JonathanCamenzuli/UG_FYP/src/coap_server/utils/README.md

In this folder, a `.env` is used and not available in the public repo. The following environment variables are used in said `.env` file:

```.env
INFLUXDB_URL    # URL of InfluxDB Instance
INFLUXDB_TOKEN  # Token provided by InfluxDB
INFLUXDB_ORG    # InfluxDB Organisation
INFLUXDB_BUCKET # InfluxDB Bucket
```
