JonathanCamenzuli/UG_FYP/docs/jc_fyp_presentation.pdf

# Miniature Implementation

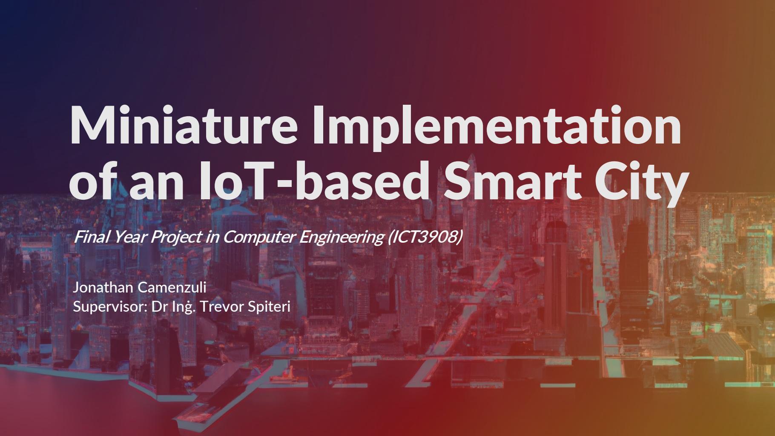
[picture p18: page 1]

Final Year Project in Computer Engineering (ICT3908)

Jonathan Camenzuli
Supervisor: Dr Inġ. Trevor Spiteri

# of an IoT‐based Smart City

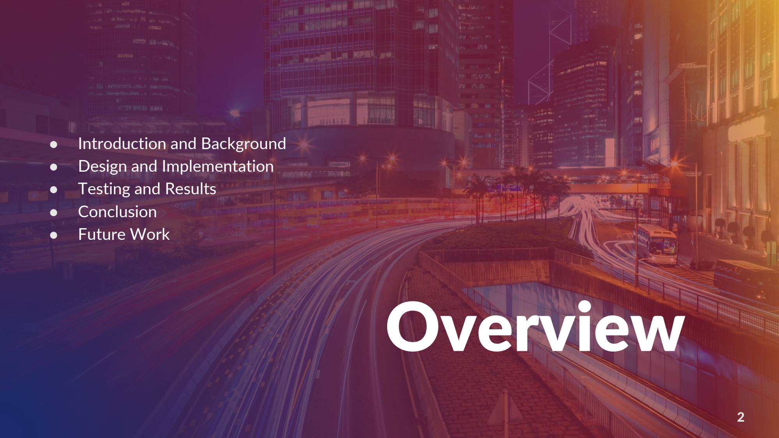
[picture p19: page 2]

# Overview

- Introduction and Background
- Design and Implementation
- Testing and Results
- Conclusion
- Future Work

2

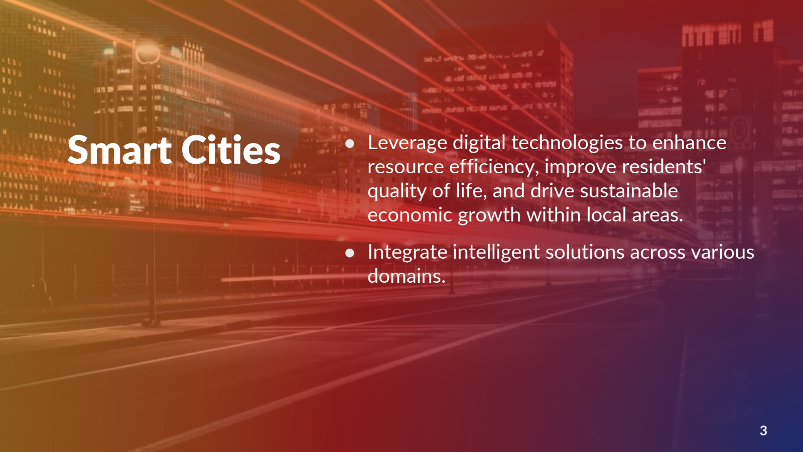
[picture p20: page 3]

Smart Cities | ● Leverage digital technologies to enhance resource efficiency, improve residents' quality of life, and drive sustainable economic growth within local areas.
| ● Integrate intelligent solutions across various domains.

3

# Technologies Enabling Smart Cities

## AI/ML

Pattern Recognition and
Autonomous System Management

## Distributed Ledger Technologies

Secure Transactions and Identities

## Internet of Things

Real-world Interface.

4

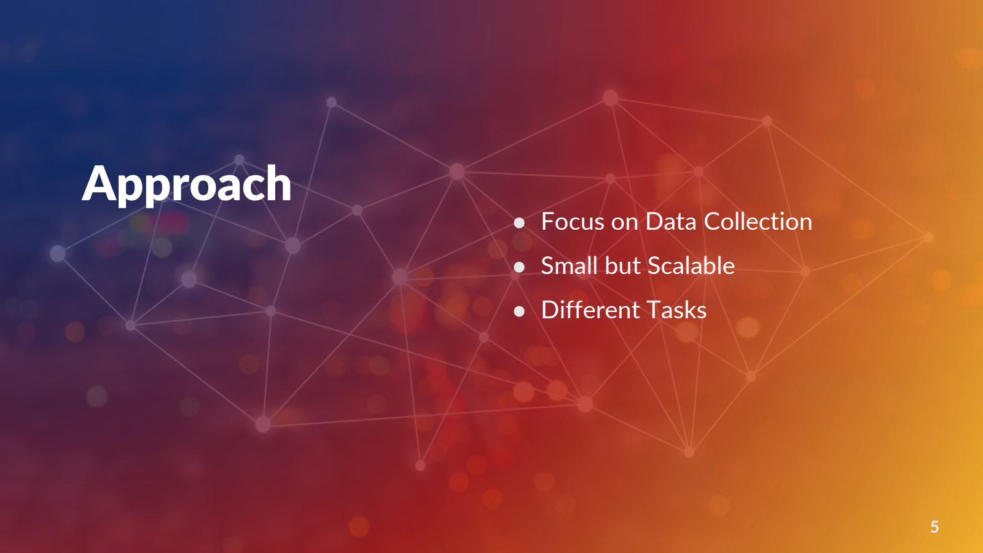
[picture p21: page 5]

# Approach

- Focus on Data Collection
- Small but Scalable
- Different Tasks

5

- Arduino MKR NB 1500
- SAMD21 Cortex®-M0+ 32bit low power ARM MCU
- u‐blox SARA‐R4 module for Narrowband Connectivity

# Physical Nodes

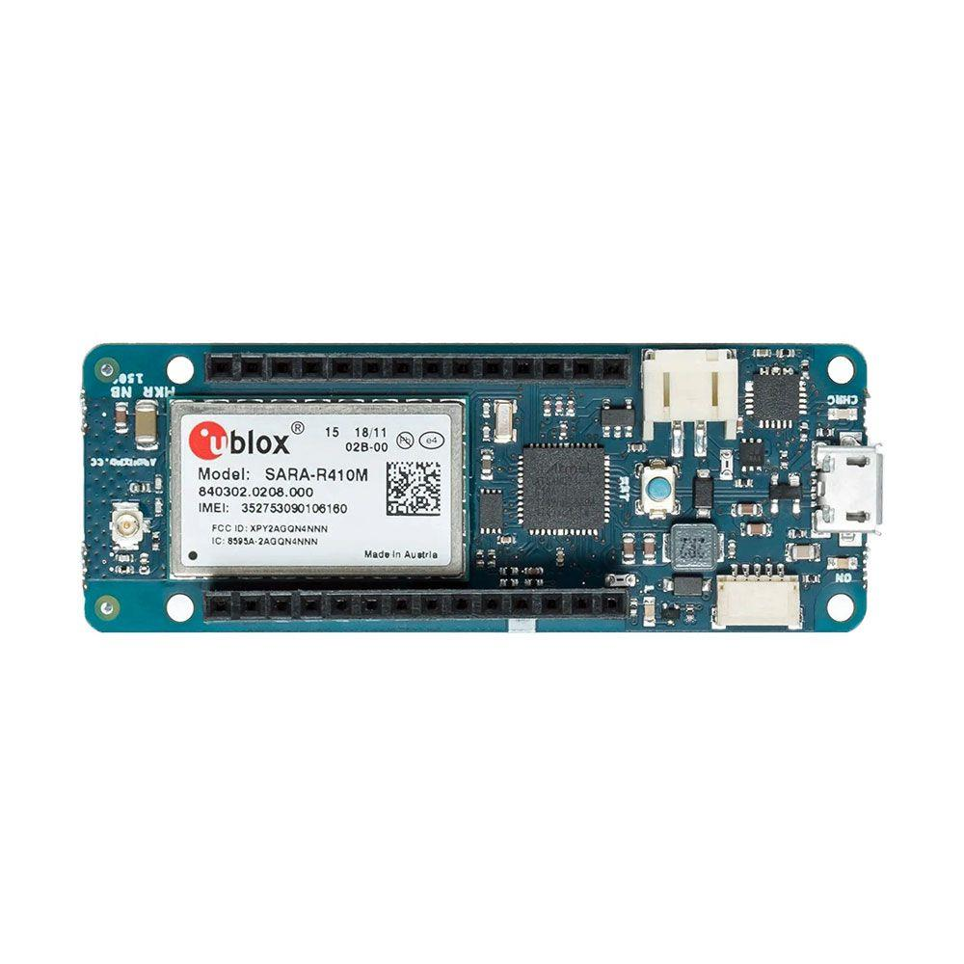
[picture p22: figure]

6

# Car Park Sensor

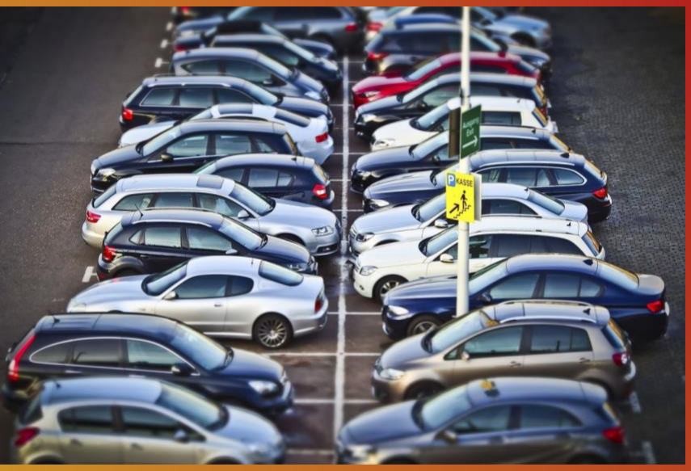
[picture p23: figure]

- Proof of concept based on a single parking spot
- Event-based
- Detects whether there is a vehicle present on the sensor
- Makes use of the HC-SR04 Ultrasonic Sensor

7

# Air Quality Monitoring System

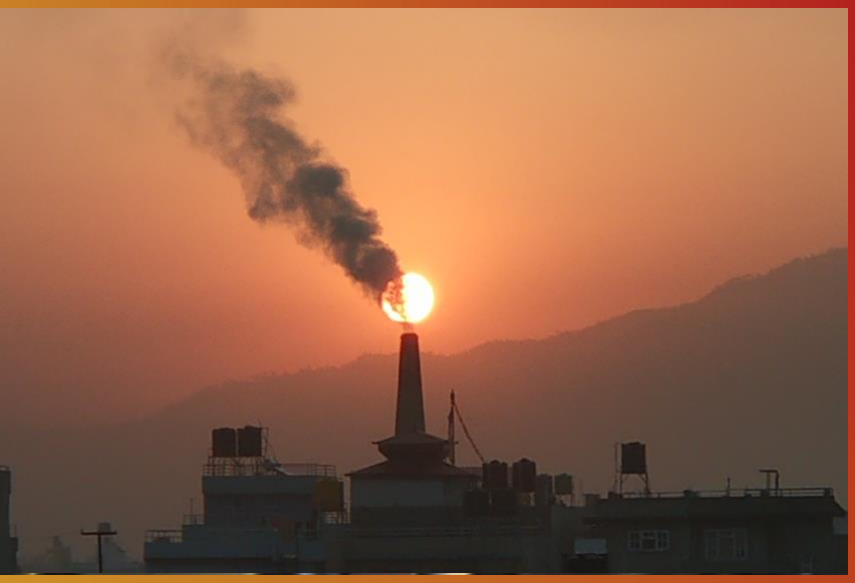
[picture p24: figure]

- Measures temperature, humidity and CO, CO2 PPM levels
- Makes use of DHT11 for measuring temperature, humidity
- Makes use of MQ-135 for
measuring CO, CO2 PPM levels

8

# Fire Detection System

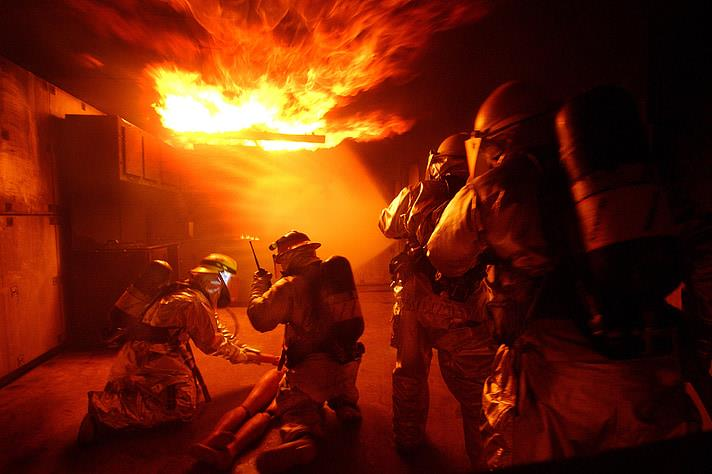
[picture p25: figure]

- Measures temperature, humidity and CO, smoke PPM levels,
presence of infrared
- Makes use of DHT11 for measuring temperature, humidity
- Makes use of MQ-4 for measuring CO, smoke PPM levels
- Makes use of an IR module for detecting infrared

9

- Centralised Server
- Star Topology
- Data Sent to the Server by making use of CoAP and NB-IoT

# System Architecture

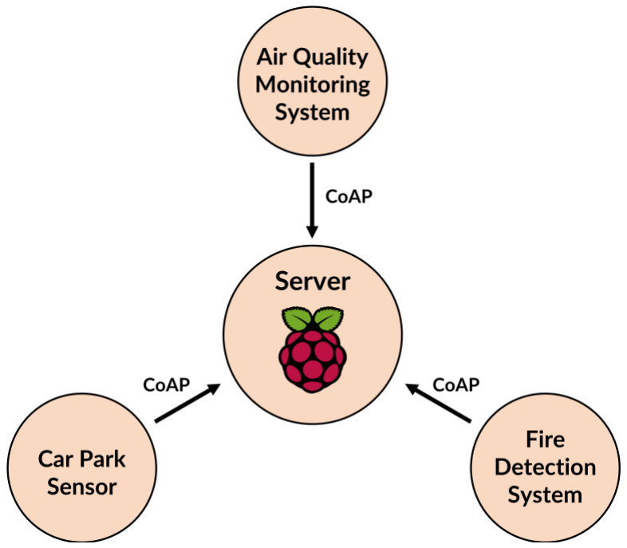
[picture p26: figure]

10

# Data Collection Pipeline

11

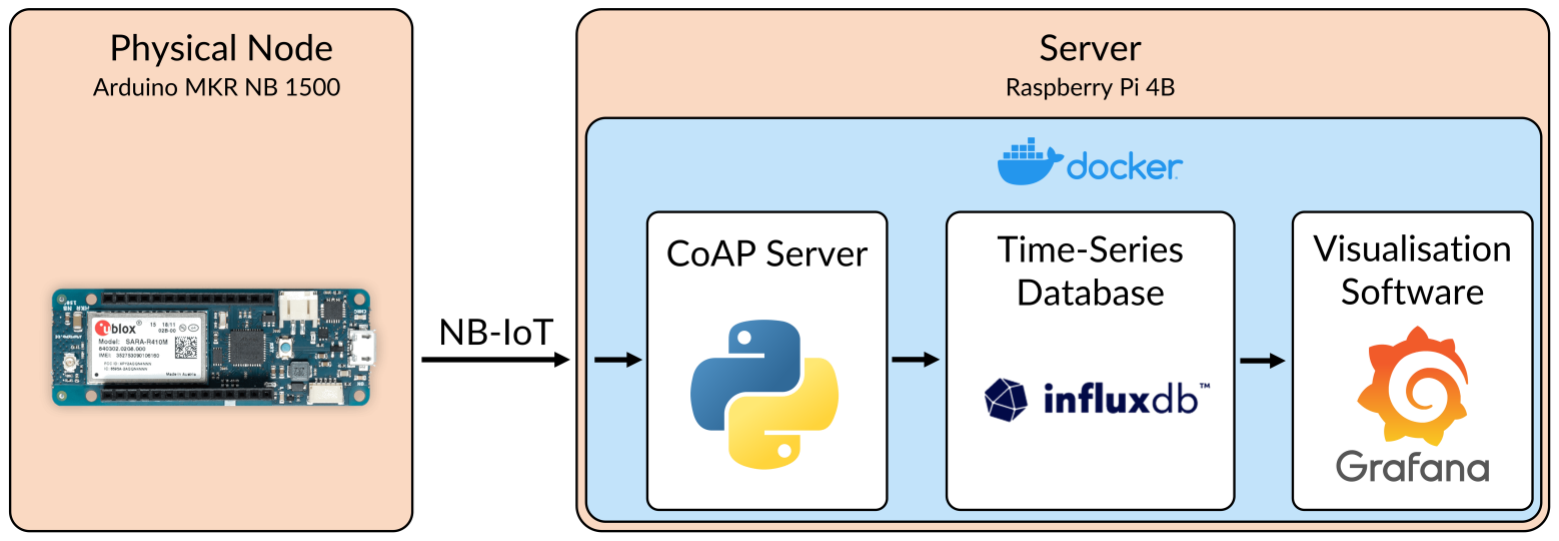
[picture p27: figure]
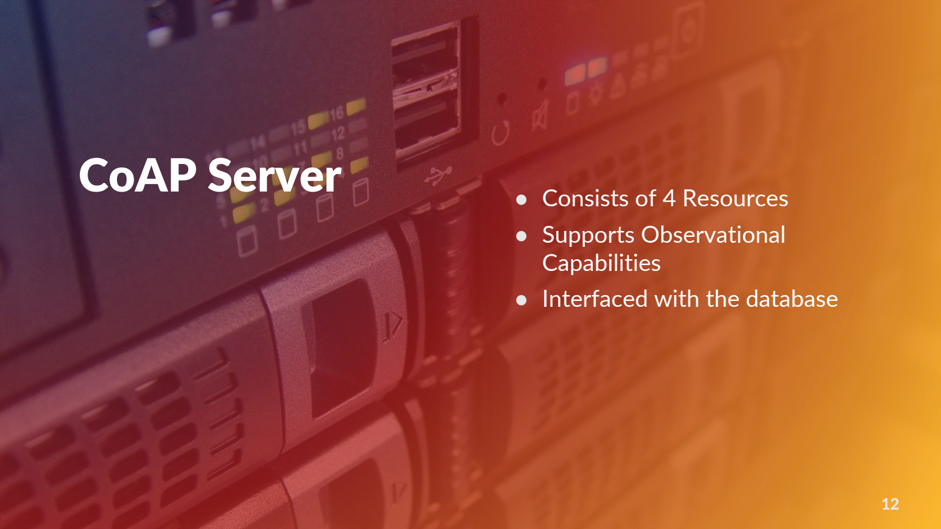
[picture p28: page 12]

# CoAP Server

- Consists of 4 Resources
- Supports Observational
Capabilities
- Interfaced with the database

12

# CoAP Server

13

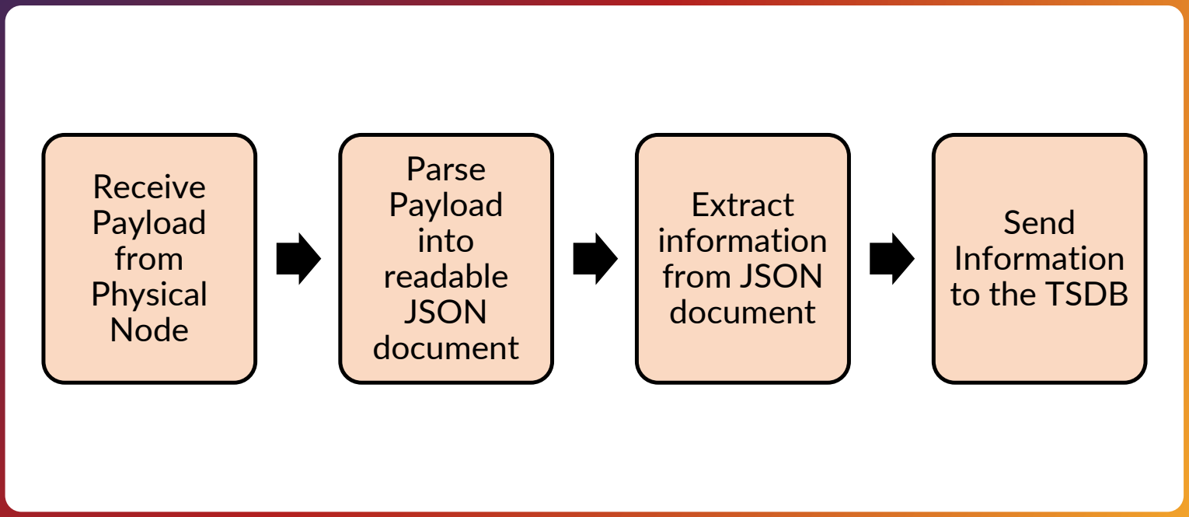
[picture p29: figure]
Receive Payload from Physical Node; Parse Payload into readable JSON document; Extract information from JSON document; Send Information to the TSDB

# Time Series

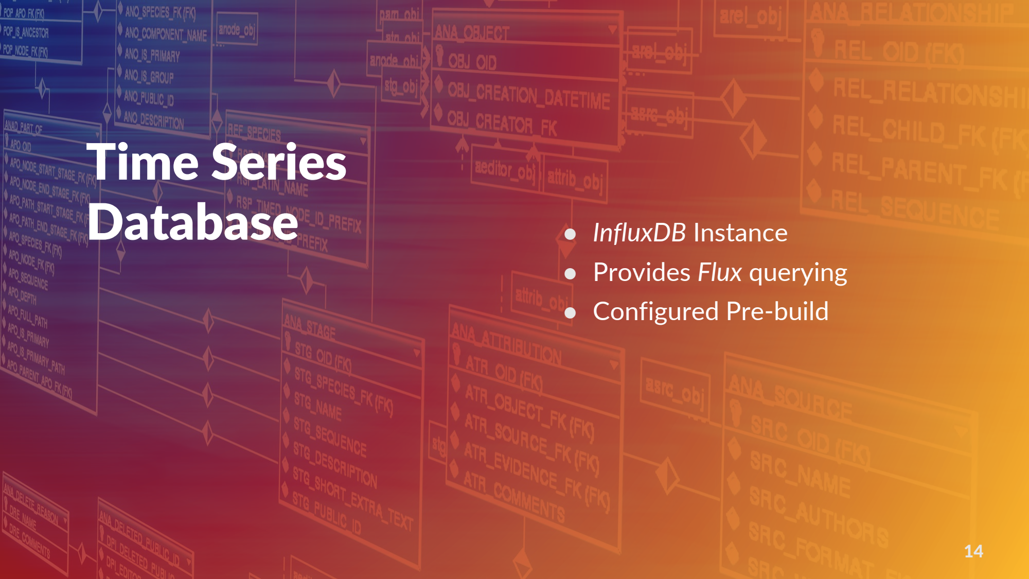
[picture p30: page 14]

Database | ● InfluxDB Instance
| ● Provides Flux querying ● Configured Pre-build

14

# Visualisation

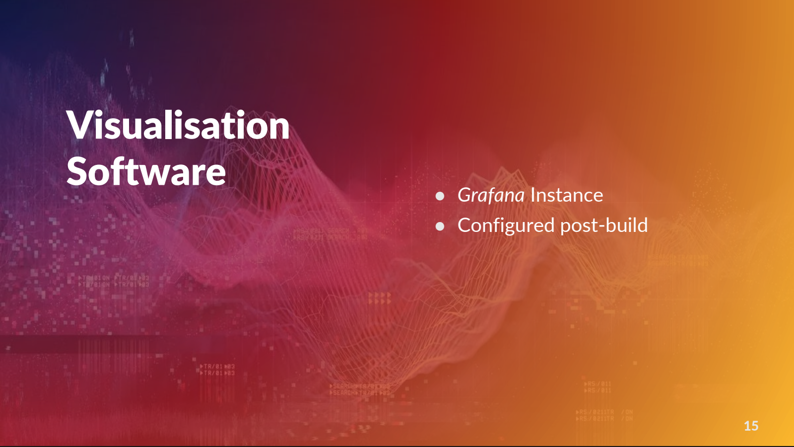
[picture p31: page 15]

# Software

- Grafana Instance
- Configured post-build

15

# Visualisation Software

16

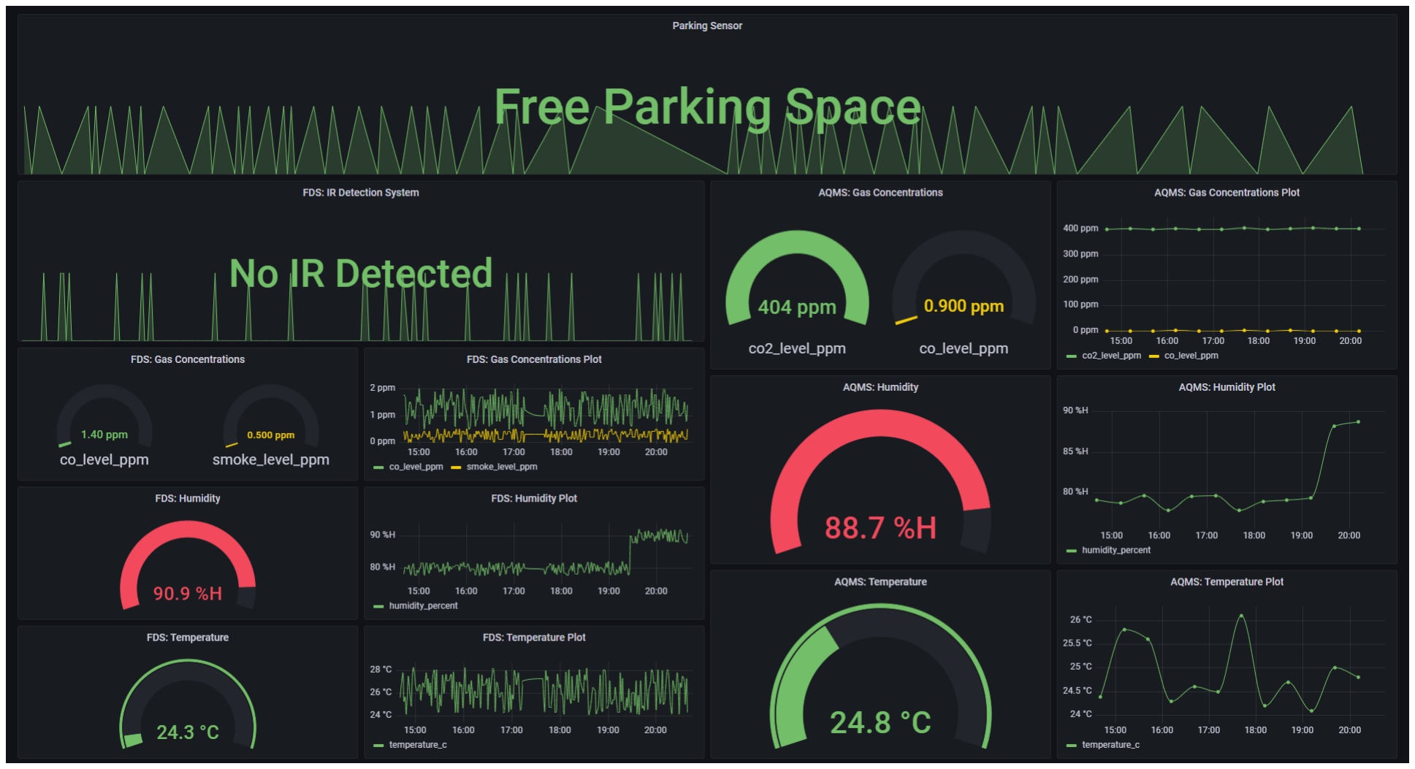
[picture p32: figure]

# Visualisation Software

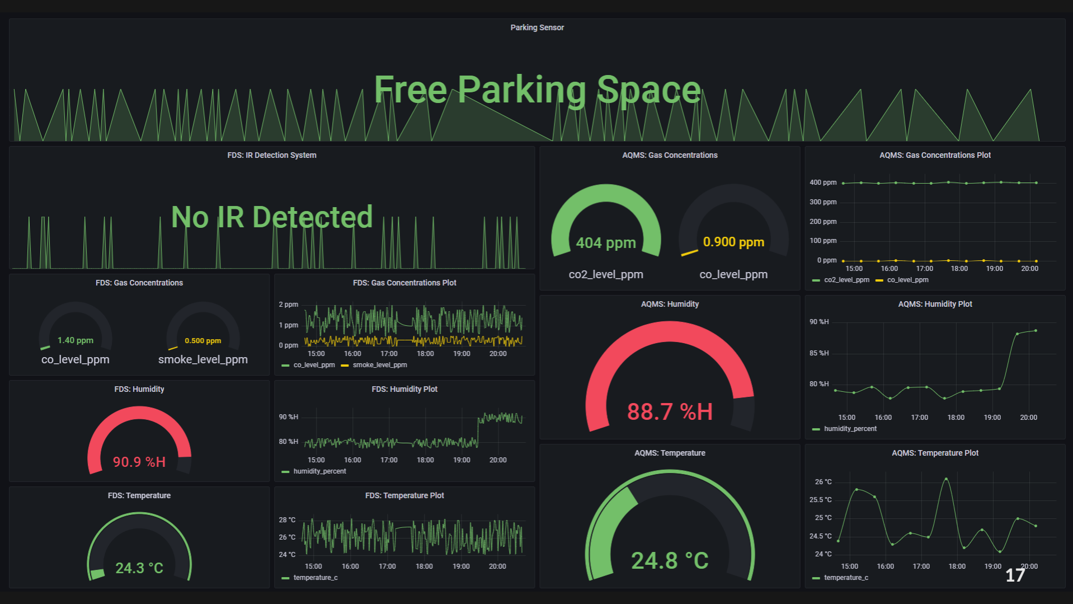
[picture p33: page 17]

17

# Prototyping

18

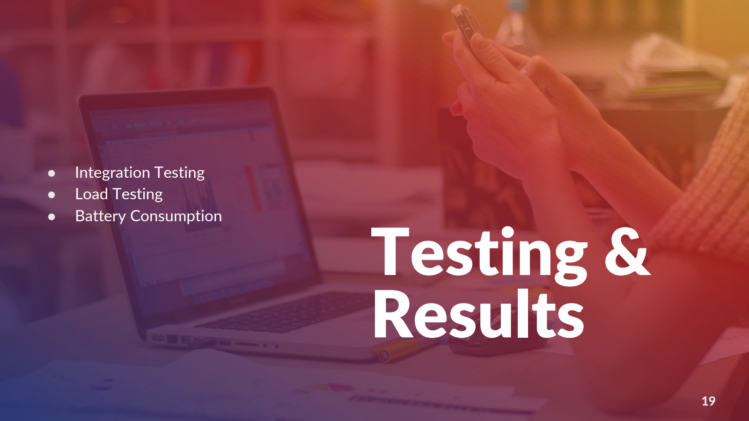
[picture p34: page 19]

# Testing & Results

- | Integration Testing ● | Load Testing ● | Battery Consumption

19

# Integration Testing

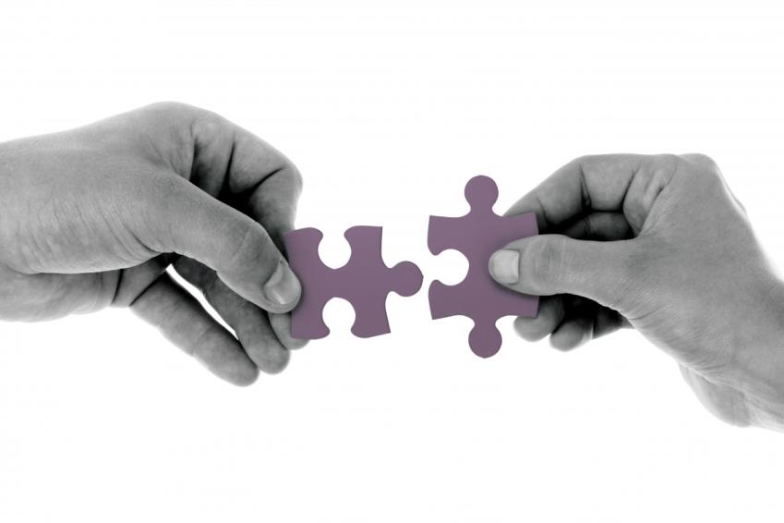
[picture p35: figure]

- Ensures proper integration and communication of all components.
- Involved sending data from test physical node to the server and verifying its receipt and processing.
- Data transmission and receipt were confirmed

20

# Load Testing

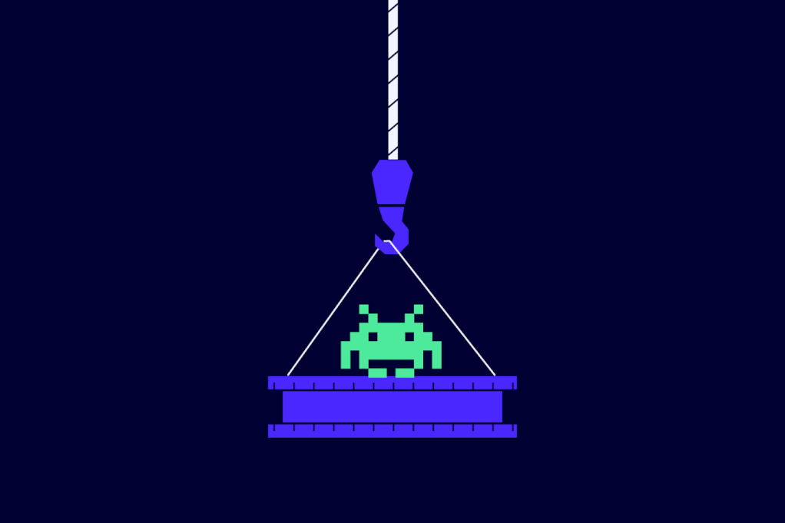
[picture p36: figure]

- Automated Testing Process
- Measuring CPU, Memory and Disk usage over 20 minutes

21

# Load Testing

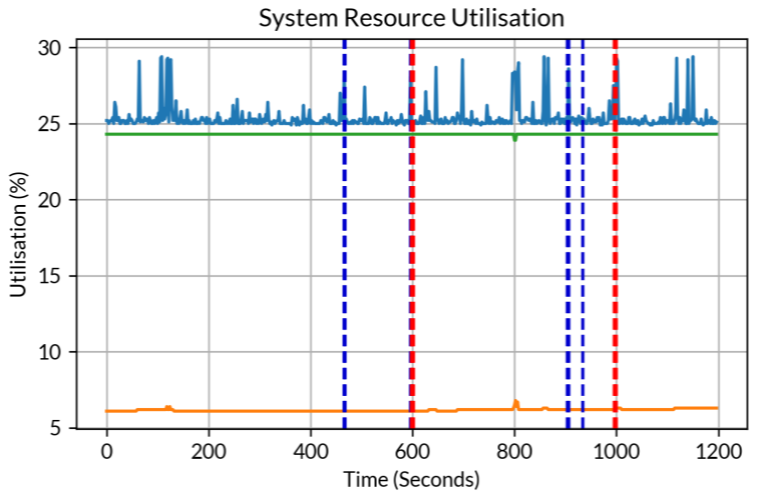
[picture p37: figure]

| CPU (%) | Memory (%) | Disk (%)
Mean | 25.35 | 6.16 | 24.30
Std. Deviation | 0.81 | 0.08 | 0.02
Minimum | 24.90 | 6.10 | 23.90
Maximum | 29.40 | 6.80 | 24.30

22

# Battery Consumption

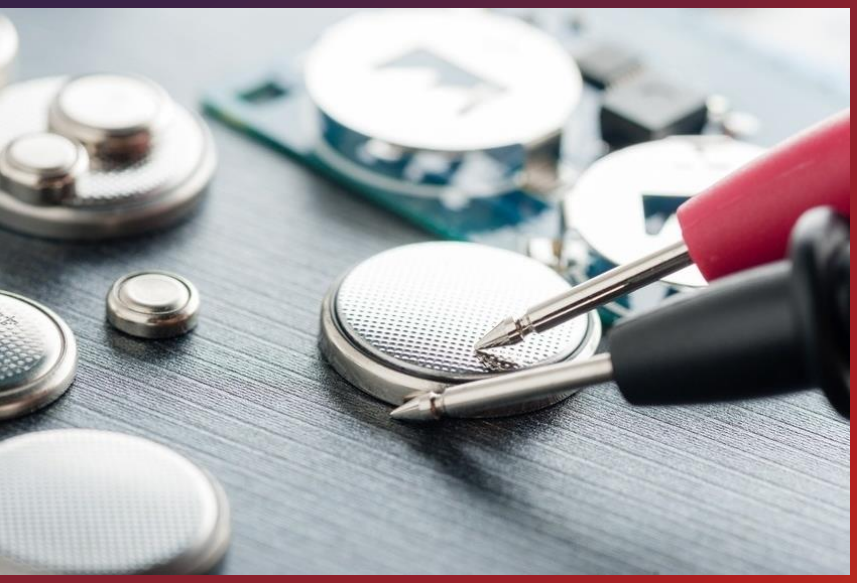
[picture p38: figure]

- Measuring current for three transmission-sleep cycles
- Measurements made using the INA219 DC Current Sensor
Breakout Board
- Measurements were logged for further analysis
- Battery life metric based on a 10,000 mAh battery

23

# Battery Consumption – CPS

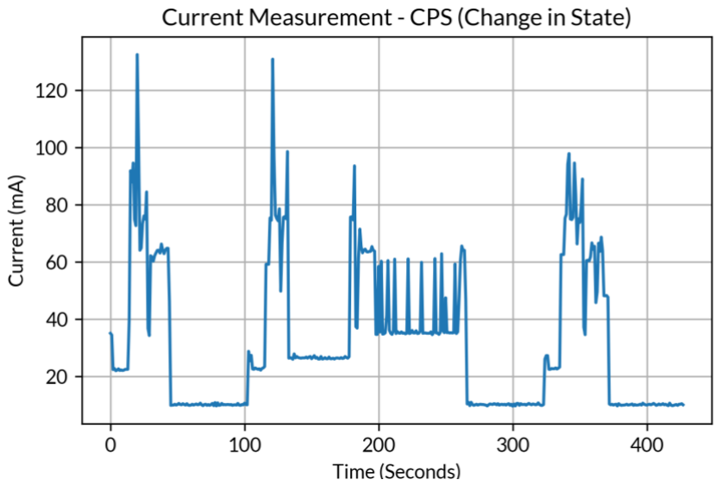
[picture p39: figure]

- Average Current Load: 32 mA
- Battery Life: N/A

24

# Battery Consumption – CPS

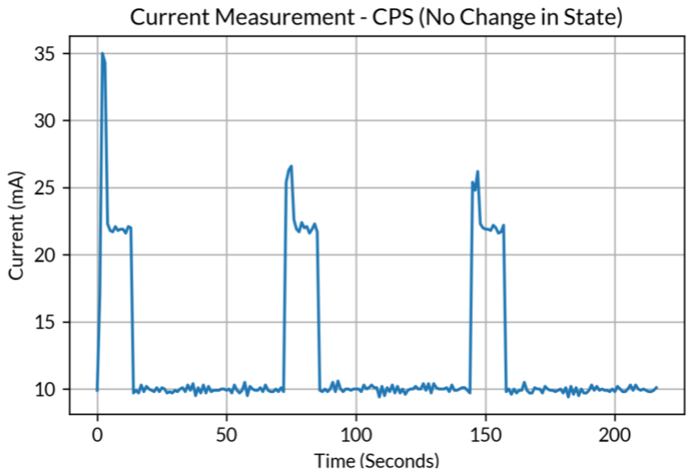
[picture p40: figure]

- Average Current Load: 12 mA
- Battery Life: N/A

25

# Battery Consumption – AQMS

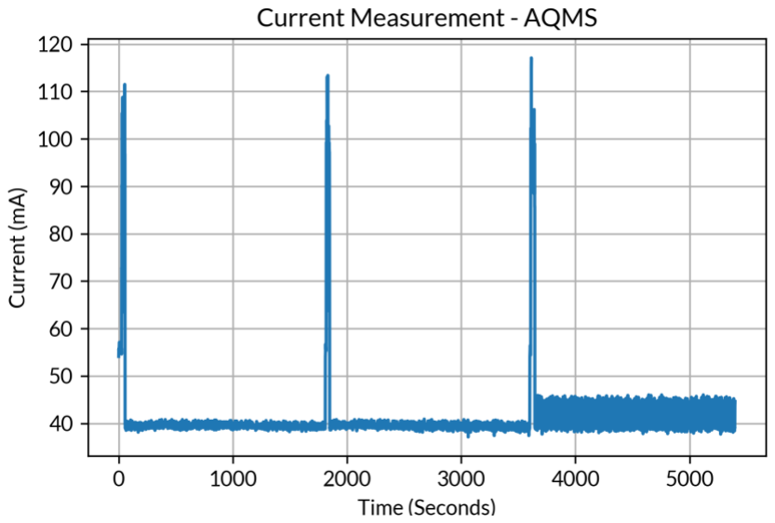
[picture p41: figure]

- Average Current Load: 41 mA
- Battery Life: 242 hours (10 days)

26

# Battery Consumption – FDS

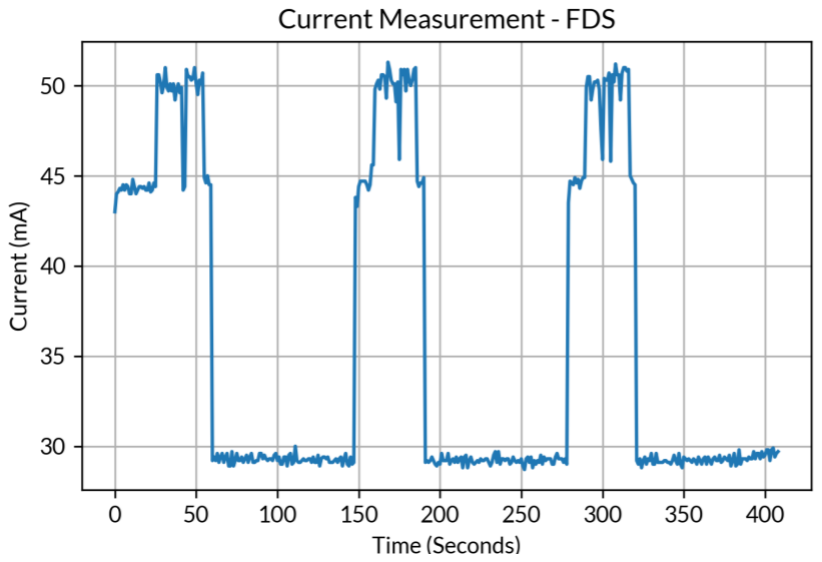
[picture p42: figure]

- Average Current Load: 36 mA
- Battery Life: 280 hours (12 days)

27

Conclusion | ● Seamless integration within data collection pipeline ● Server resource utilisation was low and stable with reasonable CPU usage range ● Battery consumption differs for each physical node due to different operating conditions ● CPS, AQMS have lowest, highest battery consumption respectively

28

# Future Work

- More robust server infrastructure
- Moving beyond the development board
- Expanding the number of physical nodes and their capabilities
- Possible integration of other technologies

29

# Thank You For Your

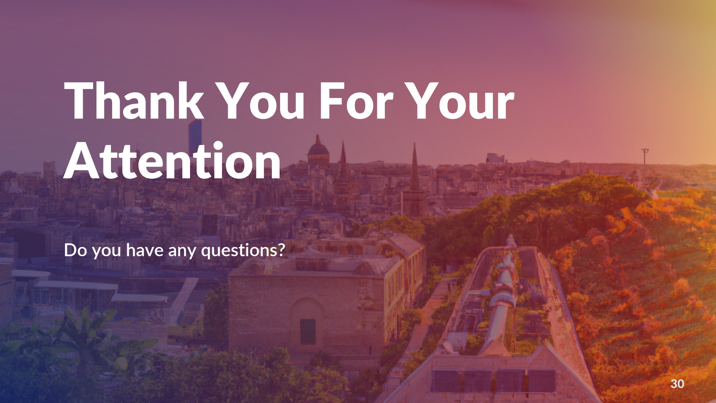
[picture p43: page 30]

# Attention

Do you have any questions?

30
