JonathanCamenzuli/UG_FYP/test/nodes/CoapTest/README.md

In this folder, `arduino_secrets.h` is used and is not available in the public repo. The following environment variables are used in said `.h` file:

```cpp
#define SECRET_PINNUMBER        // SIM card PIN number
#define SECRET_GPRS_APN         // ISP APN
#define SECRET_COAP_ENDPOINT    // CoAP Endpoint
#define SECRET_COAP_PORT        // CoAP Server Port
#define SECRET_HTTP_PORT        // IP Lookup Server Port
#define SECRET_HOSTNAME         // Server hostname
```
