JonathanCamenzuli/UG_FYP/test/battery_consumption/cps/cps_ss_timestamps.csv

Timestamps | Labels
20:08:47.663 | Setup and Collecting Data From Sensors
20:08:57.739 | No Change in State, Going to Sleep
20:10:01.758 | Wake Up and Collecting Data From Sensors
20:10:11.858 | No Change in State, Going to Sleep
20:11:15.766 | Wake Up and Collecting Data From Sensors
20:11:25.840 | No Change in State, Going to Sleep
20:12:29.751 | Wake Up and Collecting Data From Sensors
