JonathanCamenzuli/UG_FYP/test/load_testing/resource_data.csv

Timestamp | CPU (%) | Memory (%) | Disk (%) | Temperature (C)
2023-07-01 18:10:01 | 25.2 | 6.1 | 24.3 | 55.991
2023-07-01 18:10:03 | 25.2 | 6.1 | 24.3 | 56.478
2023-07-01 18:10:05 | 25.0 | 6.1 | 24.3 | 56.965
2023-07-01 18:10:07 | 25.1 | 6.1 | 24.3 | 55.991
2023-07-01 18:10:09 | 25.2 | 6.1 | 24.3 | 55.991
2023-07-01 18:10:11 | 25.2 | 6.1 | 24.3 | 55.991
2023-07-01 18:10:13 | 25.4 | 6.1 | 24.3 | 56.965
2023-07-01 18:10:15 | 25.0 | 6.1 | 24.3 | 56.478
2023-07-01 18:10:17 | 26.4 | 6.1 | 24.3 | 56.965
2023-07-01 18:10:19 | 26.1 | 6.1 | 24.3 | 56.478
2023-07-01 18:10:21 | 25.2 | 6.1 | 24.3 | 56.478
2023-07-01 18:10:23 | 25.2 | 6.1 | 24.3 | 56.965
2023-07-01 18:10:25 | 25.4 | 6.1 | 24.3 | 55.504
2023-07-01 18:10:27 | 25.0 | 6.1 | 24.3 | 56.478
2023-07-01 18:10:29 | 25.0 | 6.1 | 24.3 | 56.965
2023-07-01 18:10:31 | 25.2 | 6.1 | 24.3 | 56.965
2023-07-01 18:10:33 | 25.2 | 6.1 | 24.3 | 56.965
2023-07-01 18:10:35 | 25.2 | 6.1 | 24.3 | 56.965
2023-07-01 18:10:37 | 25.0 | 6.1 | 24.3 | 56.478
2023-07-01 18:10:39 | 25.0 | 6.1 | 24.3 | 57.452
2023-07-01 18:10:41 | 25.2 | 6.1 | 24.3 | 56.478
2023-07-01 18:10:43 | 25.0 | 6.1 | 24.3 | 56.965
2023-07-01 18:10:45 | 25.6 | 6.1 | 24.3 | 56.478
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
