JonathanCamenzuli/UG_FYP/test/battery_consumption/aqms/aqms_data.csv

Time | Current (mA)
20:59:46.017 | 53.90
20:59:47.044 | 53.70
20:59:48.070 | 54.10
20:59:49.097 | 54.40
20:59:50.124 | 54.40
20:59:51.150 | 54.30
20:59:52.177 | 54.40
20:59:53.204 | 55.10
20:59:54.230 | 54.60
20:59:55.256 | 54.30
20:59:56.283 | 54.10
20:59:57.310 | 55.70
20:59:58.337 | 55.10
20:59:59.363 | 55.70
21:00:00.390 | 55.60
21:00:01.417 | 56.30
21:00:02.443 | 57.10
21:00:03.470 | 55.10
21:00:04.496 | 56.90
21:00:05.523 | 55.20
21:00:06.550 | 55.90
21:00:07.577 | 56.40
21:00:08.603 | 55.80
21:00:09.631 | 55.40
21:00:10.658 | 55.60
21:00:11.684 | 56.80
21:00:12.711 | 55.60
21:00:13.737 | 55.40
21:00:14.765 | 55.10
21:00:15.791 | 55.00
21:00:16.819 | 55.10
21:00:17.846 | 56.30
21:00:18.872 | 55.10
21:00:19.898 | 55.60
21:00:20.925 | 55.80
21:00:21.952 | 54.60
21:00:22.979 | 72.70
21:00:24.005 | 90.20
21:00:25.032 | 88.50
21:00:26.058 | 83.40
21:00:27.087 | 105.50
21:00:28.113 | 89.50
21:00:29.141 | 89.20
21:00:30.168 | 88.90
21:00:31.195 | 108.80
21:00:32.221 | 83.40
21:00:33.249 | 102.00
21:00:34.276 | 89.40
21:00:35.303 | 88.80
21:00:36.330 | 89.90
21:00:37.357 | 91.70
21:00:38.382 | 66.30
21:00:39.409 | 63.50
21:00:40.436 | 96.00
21:00:41.463 | 94.10
21:00:42.490 | 92.10
21:00:43.517 | 99.60
21:00:44.542 | 96.90
21:00:45.570 | 100.50
21:00:46.597 | 93.40
21:00:47.624 | 80.80
21:00:48.652 | 101.50
21:00:49.679 | 111.50
21:00:50.705 | 96.80
21:00:51.732 | 39.90
21:00:52.759 | 39.90
21:00:53.785 | 38.90
21:00:54.812 | 39.60
21:00:55.840 | 39.90
21:00:56.866 | 39.20
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
21:33:31.727 | 39.50
21:33:32.754 | 39.50
21:33:33.780 | 39.60
21:33:34.808 | 39.80
21:33:35.834 | 39.50
21:33:36.861 | 39.80
21:33:37.888 | 40.20
21:33:38.915 | 39.60
21:33:39.942 | 39.70
21:33:40.969 | 39.40
21:33:41.995 | 39.00
21:33:43.022 | 39.70
21:33:44.048 | 40.40
21:33:45.075 | 39.40
21:33:46.101 | 39.70
21:33:47.127 | 39.90
21:33:48.154 | 39.40
21:33:49.181 | 39.90
21:33:50.208 | 39.20
21:33:51.235 | 39.50
21:33:52.261 | 39.40
21:33:53.288 | 39.50
21:33:54.314 | 39.50
21:33:55.341 | 39.80
21:33:56.368 | 39.40
21:33:57.395 | 38.90
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
