JonathanCamenzuli/UG_FYP/test/battery_consumption/fds/fds_data.csv

Time | Current (mA)
00:30:06.245 | 42.50
00:30:07.272 | 43.10
00:30:08.299 | 43.20
00:30:09.325 | 42.50
00:30:10.351 | 43.20
00:30:11.378 | 43.40
00:30:12.405 | 42.80
00:30:13.432 | 43.10
00:30:14.458 | 43.00
00:30:15.484 | 42.90
00:30:16.511 | 43.00
00:30:17.538 | 44.00
00:30:18.565 | 44.10
00:30:19.590 | 44.30
00:30:20.617 | 44.20
00:30:21.644 | 44.50
00:30:22.671 | 44.20
00:30:23.697 | 44.50
00:30:24.724 | 44.40
00:30:25.750 | 44.00
00:30:26.777 | 44.00
00:30:27.805 | 44.80
00:30:28.832 | 44.40
00:30:29.856 | 44.00
00:30:30.884 | 44.20
00:30:31.911 | 44.40
00:30:32.937 | 44.40
00:30:33.963 | 44.30
00:30:34.990 | 44.40
00:30:36.016 | 44.20
00:30:37.042 | 44.20
00:30:38.070 | 44.60
00:30:39.096 | 44.10
00:30:40.121 | 44.20
00:30:41.148 | 44.60
00:30:42.175 | 44.40
00:30:43.202 | 50.60
00:30:44.228 | 50.20
00:30:45.256 | 49.60
00:30:46.282 | 50.00
00:30:47.309 | 51.00
00:30:48.336 | 49.90
00:30:49.362 | 49.70
00:30:50.389 | 50.10
00:30:51.416 | 49.70
00:30:52.442 | 50.10
00:30:53.468 | 49.20
00:30:54.496 | 49.80
00:30:55.522 | 50.10
00:30:56.548 | 49.60
00:30:57.576 | 49.90
00:30:58.602 | 44.20
00:30:59.628 | 44.40
00:31:00.655 | 50.90
00:31:01.682 | 50.50
00:31:02.709 | 50.50
00:31:03.736 | 50.30
00:31:04.763 | 50.40
00:31:05.790 | 51.00
00:31:06.817 | 50.10
00:31:07.843 | 49.50
00:31:08.870 | 50.30
00:31:09.897 | 50.10
00:31:10.923 | 50.70
00:31:11.950 | 44.90
00:31:12.976 | 44.60
00:31:14.003 | 45.00
00:31:15.030 | 44.50
00:31:16.056 | 44.50
00:31:17.083 | 29.20
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
00:37:03.083 | 29.40
00:37:04.110 | 29.50
00:37:05.137 | 29.80
00:37:06.165 | 29.80
00:37:07.191 | 29.20
00:37:08.217 | 29.80
00:37:09.244 | 29.90
00:37:10.271 | 29.40
00:37:11.297 | 29.60
00:37:12.325 | 29.70
00:37:13.351 | 47.10
00:37:14.376 | 44.10
00:37:15.403 | 44.20
00:37:16.429 | 44.20
