JonathanCamenzuli/UG_FYP/test/battery_consumption/cps/cps_cis_data.csv

Time | Current (mA)
19:37:06.144 | 34.20
19:37:07.170 | 34.40
19:37:08.196 | 34.60
19:37:09.222 | 34.40
19:37:10.250 | 34.70
19:37:11.276 | 34.50
19:37:12.303 | 34.40
19:37:13.329 | 34.90
19:37:14.355 | 34.20
19:37:15.383 | 34.50
19:37:16.409 | 35.10
19:37:17.436 | 34.50
19:37:18.463 | 22.40
19:37:19.489 | 22.80
19:37:20.516 | 22.00
19:37:21.543 | 22.20
19:37:22.570 | 22.70
19:37:23.597 | 22.10
19:37:24.622 | 22.30
19:37:25.650 | 22.10
19:37:26.677 | 22.20
19:37:27.702 | 22.50
19:37:28.729 | 39.70
19:37:29.756 | 91.90
19:37:30.783 | 88.00
19:37:31.809 | 94.60
19:37:32.836 | 74.90
19:37:33.863 | 72.70
19:37:34.890 | 132.50
19:37:35.918 | 101.40
19:37:36.943 | 64.10
19:37:37.970 | 64.90
19:37:38.996 | 73.50
19:37:40.023 | 76.10
19:37:41.049 | 75.00
19:37:42.076 | 84.50
19:37:43.103 | 36.80
19:37:44.129 | 34.30
19:37:45.156 | 62.20
19:37:46.182 | 61.70
19:37:47.209 | 60.30
19:37:48.236 | 62.20
19:37:49.263 | 63.20
19:37:50.289 | 64.10
19:37:51.316 | 64.10
19:37:52.343 | 63.10
19:37:53.368 | 66.30
19:37:54.396 | 64.20
19:37:55.423 | 62.90
19:37:56.449 | 64.20
19:37:57.476 | 64.80
19:37:58.503 | 46.20
19:37:59.528 | 9.90
19:38:00.554 | 10.00
19:38:01.582 | 10.00
19:38:02.608 | 10.30
19:38:03.635 | 10.00
19:38:04.661 | 10.20
19:38:05.689 | 10.60
19:38:06.715 | 10.20
19:38:07.741 | 10.10
19:38:08.767 | 10.50
19:38:09.794 | 10.20
19:38:10.821 | 10.00
19:38:11.847 | 10.50
19:38:12.874 | 10.00
19:38:13.900 | 9.90
19:38:14.927 | 10.00
19:38:15.953 | 10.30
19:38:16.980 | 10.00
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
19:44:10.122 | 10.50
19:44:11.148 | 10.10
19:44:12.176 | 10.30
19:44:13.201 | 10.00
19:44:14.227 | 9.80
19:44:15.254 | 10.70
19:44:16.280 | 10.00
19:44:17.306 | 9.80
19:44:18.332 | 9.90
19:44:19.359 | 10.10
19:44:20.385 | 10.20
19:44:21.410 | 9.90
19:44:22.437 | 10.30
19:44:23.464 | 10.30
19:44:24.490 | 10.50
19:44:25.517 | 10.10
19:44:26.543 | 25.60
19:44:27.570 | 27.60
19:44:28.597 | 27.20
19:44:29.623 | 22.80
19:44:30.650 | 22.80
19:44:31.677 | 22.70
19:44:32.704 | 22.90
19:44:33.731 | 22.60
19:44:34.757 | 22.30
19:44:35.785 | 22.80
19:44:36.811 | 22.80
19:44:37.837 | 22.80
