JonathanCamenzuli/UG_FYP/test/battery_consumption/cps/cps_data.csv

Time | Current (mA)
12:08:50.396 | 55.10
12:08:51.423 | 54.20
12:08:52.450 | 54.20
12:08:53.476 | 54.90
12:08:54.504 | 54.50
12:08:55.530 | 54.70
12:08:56.556 | 55.20
12:08:57.583 | 54.50
12:08:58.610 | 54.40
12:08:59.636 | 55.10
12:09:00.663 | 54.40
12:09:01.690 | 54.60
12:09:02.716 | 42.30
12:09:03.744 | 42.40
12:09:04.769 | 42.60
12:09:05.796 | 42.70
12:09:06.823 | 42.60
12:09:07.850 | 42.70
12:09:08.876 | 41.90
12:09:09.902 | 42.80
12:09:10.930 | 42.40
12:09:11.956 | 42.30
12:09:12.983 | 62.30
12:09:14.009 | 61.80
12:09:15.035 | 61.40
12:09:16.062 | 62.10
12:09:17.088 | 62.00
12:09:18.116 | 61.90
12:09:19.142 | 62.10
12:09:20.168 | 61.70
12:09:21.195 | 62.30
12:09:22.221 | 61.90
12:09:23.248 | 61.80
12:09:24.275 | 62.10
12:09:25.301 | 61.70
12:09:26.327 | 61.60
12:09:27.353 | 57.80
12:09:28.380 | 55.00
12:09:29.407 | 63.40
12:09:30.434 | 62.80
12:09:31.461 | 62.10
12:09:32.487 | 63.50
12:09:33.514 | 62.50
12:09:34.540 | 63.20
12:09:35.567 | 63.40
12:09:36.594 | 60.50
12:09:37.621 | 63.20
12:09:38.648 | 63.20
12:09:39.674 | 62.50
12:09:40.702 | 62.90
12:09:41.728 | 63.10
12:09:42.755 | 62.50
12:09:43.781 | 59.60
12:09:44.809 | 63.00
12:09:45.835 | 61.10
12:09:46.861 | 55.50
12:09:47.889 | 63.30
12:09:48.915 | 55.10
12:09:49.941 | 55.60
12:09:50.969 | 56.00
12:09:51.996 | 55.40
12:09:53.022 | 62.60
12:09:54.048 | 55.90
12:09:55.076 | 56.30
12:09:56.102 | 55.80
12:09:57.129 | 57.30
12:09:58.156 | 55.00
12:09:59.183 | 55.50
12:10:00.210 | 55.60
12:10:01.237 | 55.70
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
12:13:26.590 | 30.70
12:13:27.617 | 30.30
12:13:28.643 | 30.30
12:13:29.671 | 30.50
12:13:30.698 | 30.80
12:13:31.725 | 30.50
12:13:32.752 | 30.50
12:13:33.778 | 30.60
12:13:34.805 | 30.40
12:13:35.833 | 30.60
12:13:36.859 | 30.80
12:13:37.885 | 29.90
12:13:38.912 | 30.20
12:13:39.939 | 30.10
12:13:40.966 | 30.30
12:13:41.992 | 30.60
12:13:43.019 | 30.60
12:13:44.046 | 31.10
12:13:45.073 | 30.50
12:13:46.100 | 30.40
12:13:47.126 | 30.30
12:13:48.152 | 30.40
12:13:49.179 | 30.50
12:13:50.207 | 30.70
12:13:51.233 | 30.70
12:13:52.260 | 30.40
12:13:53.286 | 30.30
12:13:54.313 | 30.40
12:13:55.340 | 30.60
12:13:56.367 | 30.70
12:13:57.394 | 30.80
12:13:58.420 | 30.80
12:13:59.448 | 30.70
12:14:00.473 | 30.70
12:14:01.500 | 30.80
12:14:02.527 | 31.10
12:14:03.554 | 30.80
12:14:04.581 | 45.70
12:14:05.607 | 45.70
12:14:06.635 | 47.40
