JonathanCamenzuli/UG_FYP/test/battery_consumption/cps/cps_ss_data.csv

Time | Current (mA)
20:08:28.925 | 9.70
20:08:29.950 | 9.90
20:08:30.977 | 9.80
20:08:32.002 | 9.80
20:08:33.029 | 10.00
20:08:34.055 | 10.10
20:08:35.080 | 9.90
20:08:36.107 | 10.30
20:08:37.133 | 9.80
20:08:38.160 | 10.00
20:08:39.186 | 10.00
20:08:40.211 | 9.90
20:08:41.239 | 10.00
20:08:42.264 | 9.90
20:08:43.290 | 9.70
20:08:44.315 | 9.90
20:08:45.343 | 17.00
20:08:46.368 | 35.00
20:08:47.395 | 34.30
20:08:48.422 | 22.30
20:08:49.449 | 21.80
20:08:50.475 | 21.70
20:08:51.501 | 22.10
20:08:52.528 | 21.80
20:08:53.555 | 21.90
20:08:54.581 | 21.90
20:08:55.607 | 21.60
20:08:56.634 | 22.10
20:08:57.660 | 22.00
20:08:58.685 | 9.70
20:08:59.711 | 9.90
20:09:00.737 | 9.70
20:09:01.763 | 10.30
20:09:02.790 | 9.80
20:09:03.816 | 10.20
20:09:04.843 | 10.00
20:09:05.869 | 9.90
20:09:06.894 | 9.80
20:09:07.921 | 10.10
20:09:08.946 | 9.80
20:09:09.973 | 10.10
20:09:10.999 | 10.00
20:09:12.025 | 9.70
20:09:13.051 | 9.80
20:09:14.076 | 9.70
20:09:15.102 | 9.90
20:09:16.128 | 9.80
20:09:17.155 | 10.00
20:09:18.181 | 10.10
20:09:19.207 | 9.80
20:09:20.233 | 10.30
20:09:21.259 | 9.90
20:09:22.285 | 10.40
20:09:23.311 | 9.50
20:09:24.338 | 10.10
20:09:25.363 | 9.70
20:09:26.390 | 10.30
20:09:27.415 | 9.70
20:09:28.442 | 10.20
20:09:29.467 | 9.80
20:09:30.493 | 9.90
20:09:31.519 | 9.90
20:09:32.544 | 9.90
20:09:33.571 | 10.00
20:09:34.598 | 10.00
20:09:35.623 | 9.90
20:09:36.651 | 10.00
20:09:37.675 | 9.70
20:09:38.703 | 10.30
20:09:39.728 | 9.90
20:09:40.754 | 9.70
20:09:41.779 | 9.90
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
20:12:19.822 | 9.90
20:12:20.849 | 10.00
20:12:21.875 | 9.90
20:12:22.900 | 9.80
20:12:23.926 | 9.80
20:12:24.952 | 9.90
20:12:25.979 | 10.10
20:12:27.005 | 24.90
20:12:28.032 | 25.20
20:12:29.058 | 27.10
20:12:30.085 | 22.10
20:12:31.112 | 22.20
20:12:32.138 | 22.80
20:12:33.165 | 21.80
