JonathanCamenzuli/UG_FYP/test/battery_consumption/assets/aqms_plot.png

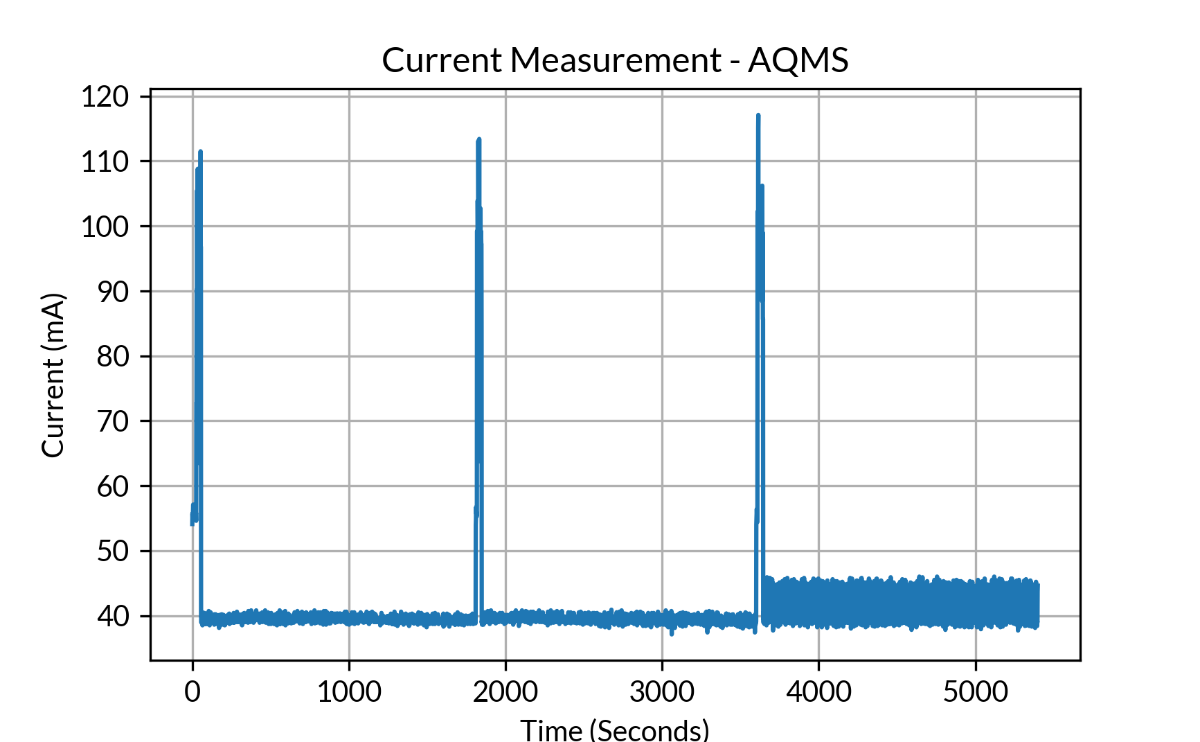
test/battery_consumption/assets/aqms_plot.png
