JonathanCamenzuli/UG_FYP/test/battery_consumption/assets/cps_cis_plot.png

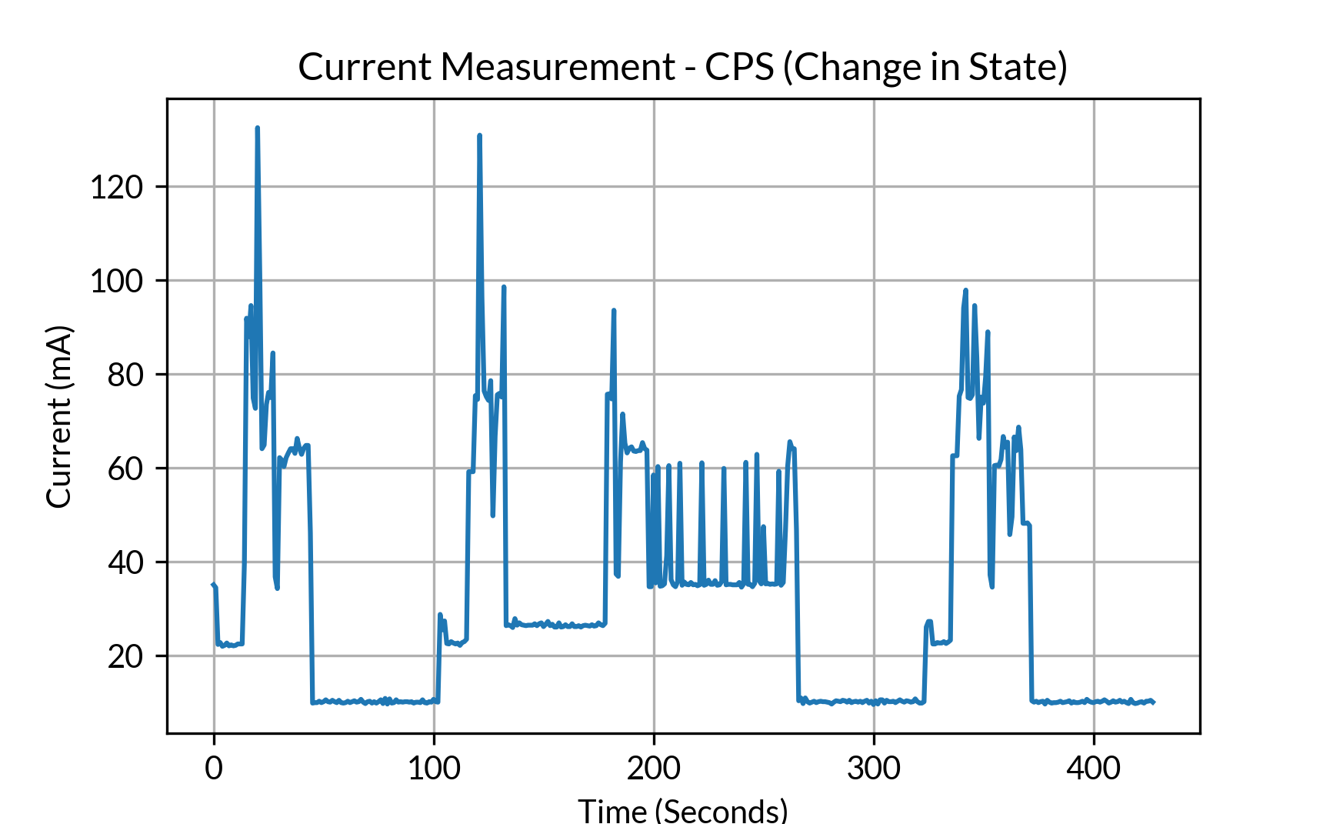
test/battery_consumption/assets/cps_cis_plot.png
