JonathanCamenzuli/UG_FYP/test/battery_consumption/assets/cps_ss_plot.png

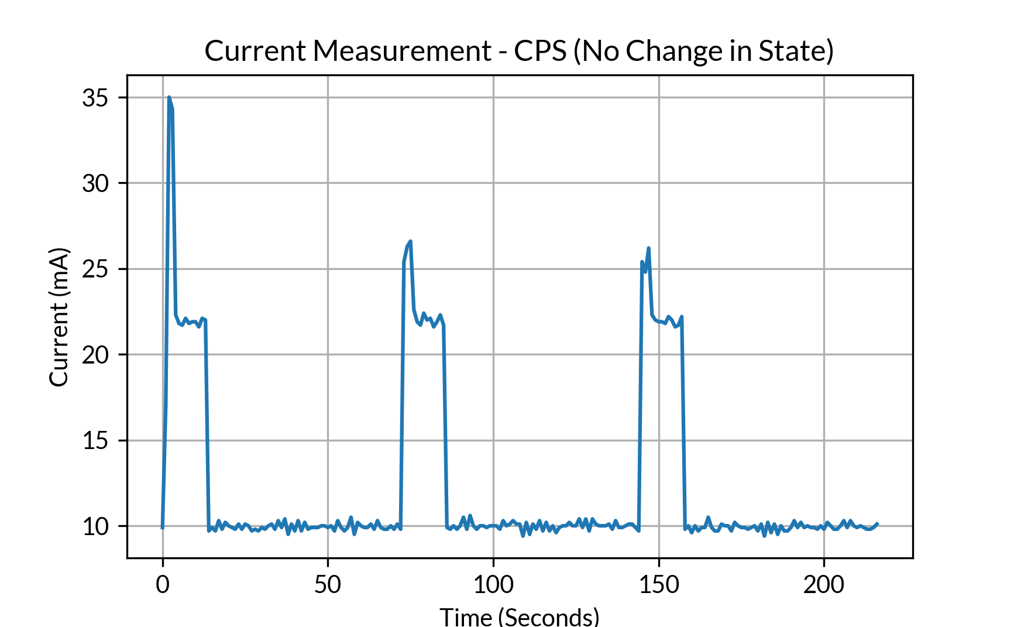
test/battery_consumption/assets/cps_ss_plot.png
