JonathanCamenzuli/UG_FYP/test/battery_consumption/assets/fds_plot.png

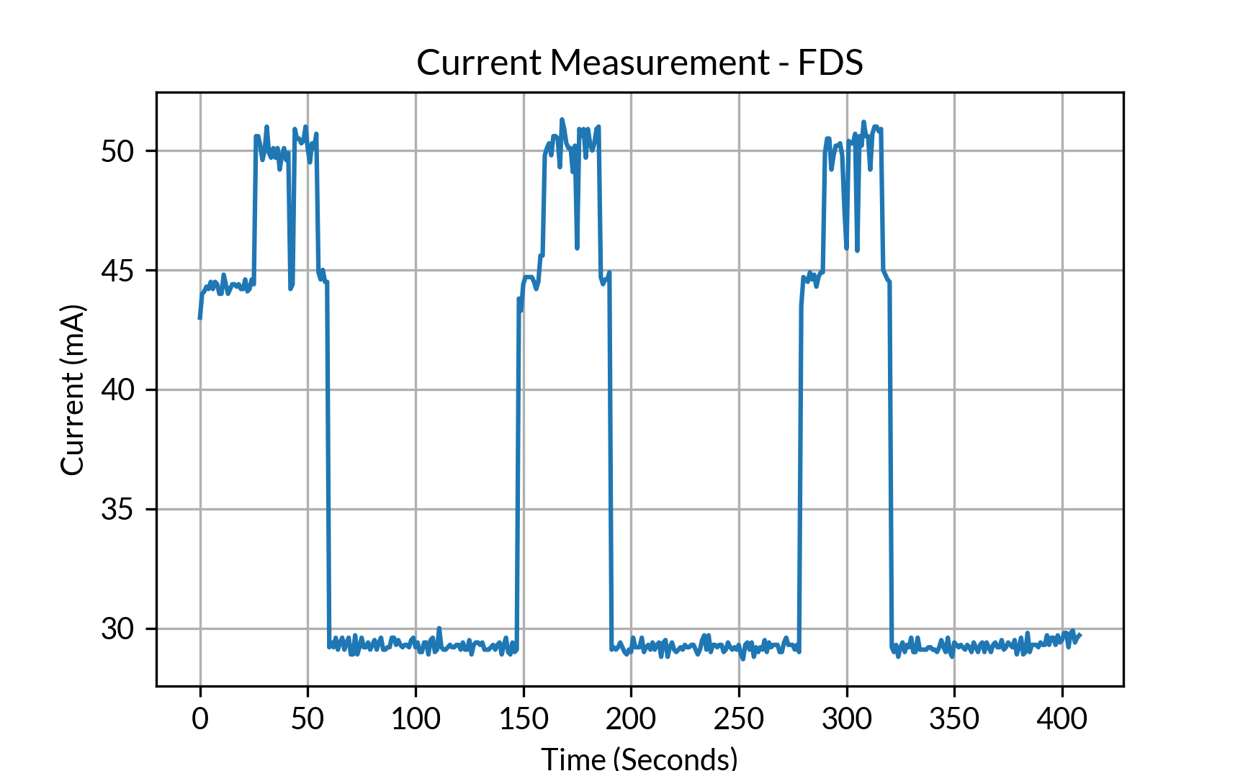
test/battery_consumption/assets/fds_plot.png
