JonathanCamenzuli/UG_FYP/test/load_testing/assets/load_plot.png

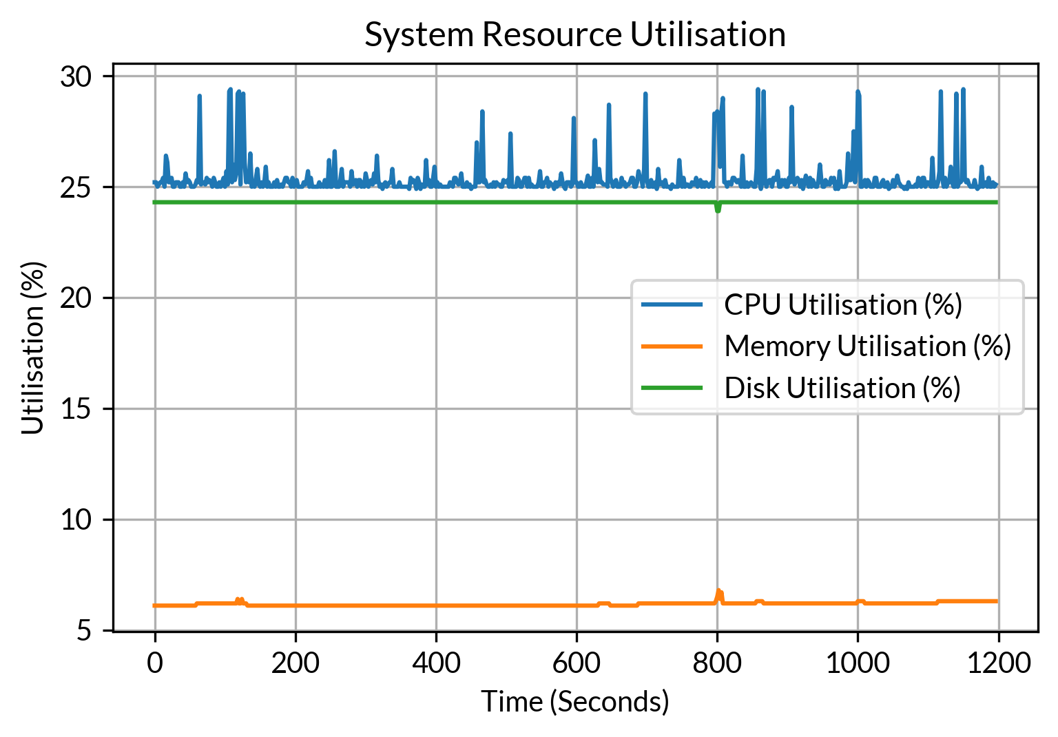
test/load_testing/assets/load_plot.png
