JonathanCamenzuli/UG_FYP/test/load_testing/assets/load_plot.pdf

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

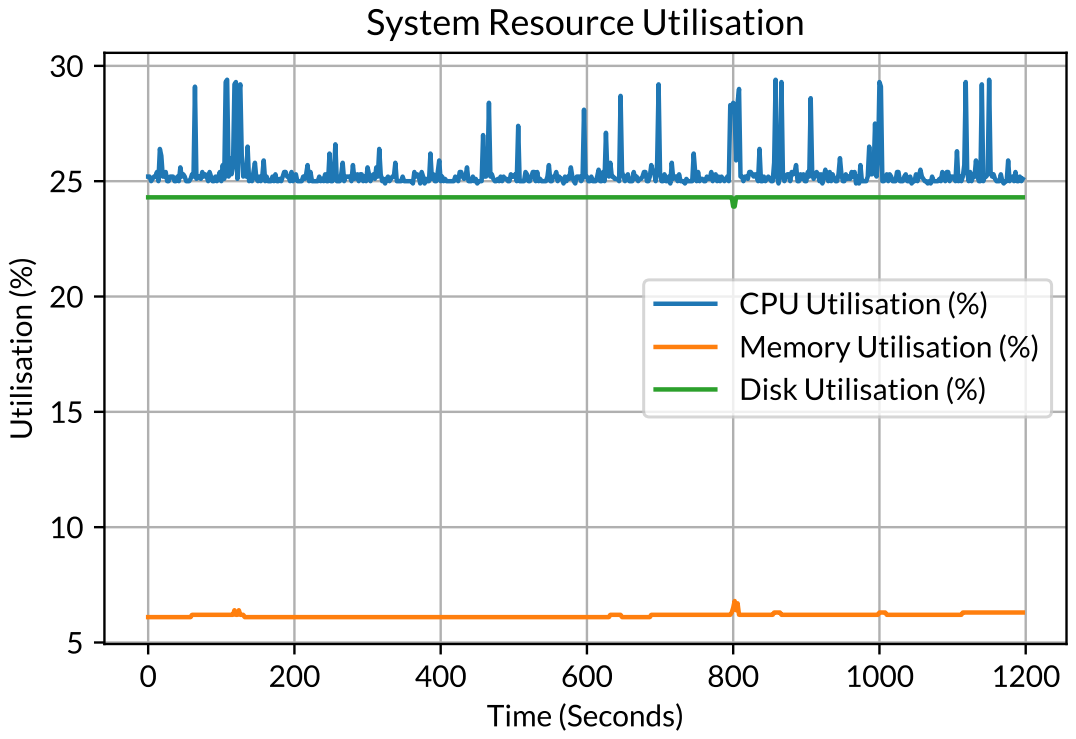
[picture p52: page 1]
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
