JonathanCamenzuli/UG_FYP/test/battery_consumption/assets/cps_ss_plot.pdf

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

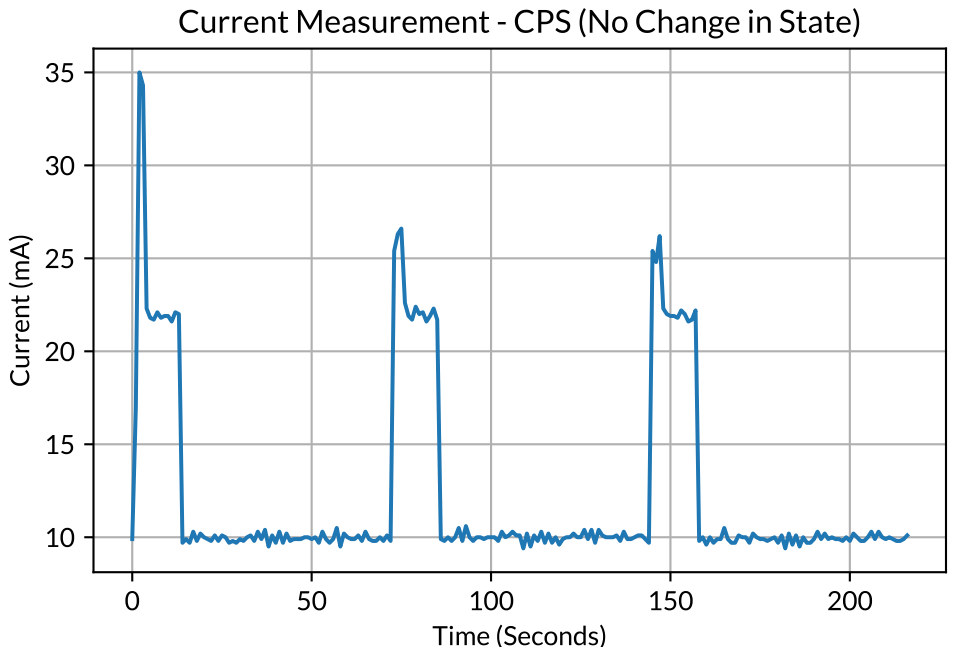
[picture p56: page 1]
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
