JonathanCamenzuli/UG_FYP/test/nodes/DHT11/DHT11.ino

/**
 * @file DHT11.ino
 *
 * @author Jonathan Camenzuli
 *
 * @brief DHT11 Sensor Test
 *
 * Source code is part of my Final Year Project in Computer Engineering (2022/23) entitled
 * "Miniature implementation of an IoT-based Smart City"
 *
 * @date 01/05/2023
 *
 * @section hardware Hardware
 * -  Arduino MKR NB 1500
 * -  DHT11 Temperature and Humidity Sensor
 */

#include <DHT.h>
#include <DHT_U.h>

#define DHTTYPE DHT11

const int dhtPin = 0;

DHT dht(dhtPin, DHTTYPE);

void setup() {
  Serial.begin(9600);
  Serial.println(F("DHTxx test!"));

  dht.begin();
}

void loop() {
  // Wait a few seconds between measurements.
  delay(2000);

  // Reading temperature or humidity takes about 250 milliseconds!
  // Sensor readings may also be up to 2 seconds 'old' (its a very slow sensor)
  float h = dht.readHumidity();
  // Read temperature as Celsius (the default)
  float t = dht.readTemperature();

  // Check if any reads failed and exit early (to try again).
  if (isnan(h) || isnan(t)) {
    Serial.println(F("Failed to read from DHT sensor!"));
    return;
  }

  // Compute heat index in Celsius (isFahreheit = false)
  float hic = dht.computeHeatIndex(t, h, false);

  Serial.print(F("Humidity: "));
  Serial.print(h);
  Serial.print(F("%  Temperature: "));
  Serial.print(t);
  Serial.print(F("°C "));
  Serial.print(F("Heat index: "));
  Serial.print(hic);
  Serial.println(F("°C "));
}
