JonathanCamenzuli/UG_FYP/(commit log)

2022-11-30 Added car park sensor source code
2022-12-01 Added arduino_secrets.h
2022-12-13 FireDetectionSystem_bp - Basic Flame Sensor Boilerplate
2022-12-18 Added referencing to arrayMAX and fixed gasReadings_i issue in FireDetectionSystem_bp
    [CarParkSensor_bp.ino]
2023-01-06 Fixed sensor/node id issue in CPS_Resource
2023-01-06 Added test Car Park Sensor client
2023-01-12 Changed temperature object is FDS payload
2023-02-15 Added Ultrasonic Sensor Test
2023-02-15 Added first working version on MKR1500 (Sleep not working)
    [CarParkSensor.h, CarParkSensor.ino]
2023-02-18 Added Docker Powershell build script
2023-03-01 Abstracted Ultrasonic Reading Function
2023-03-09 Moved UltrasonicSensor test out of CarParkSensor
2023-03-11 Resolved Restart Policy Issue in Powershell Script
2023-03-15 Updated Ultrasonic Reading Function
2023-03-23 Changed de/encoding to UTF-8 in Test Resource
2023-03-28 Changed de/encoding to UTF-8 in all CoAP resources
2023-05-06 Fixed issue relating to reading incorrect MQ-135 values
    [AirQualityMonitoringSystem.cpp, AirQualityMonitoringSystem.h, AirQualityMonitoringSystem.ino]
2023-05-11 Added FDS and updated MQ sensor coefficients for AQMS
2023-05-11 Updated Objectives related to MQ sensors
2023-05-12 Added initial version for Battery Consumption Data Logging - UNTESTED
2023-06-11 Updated Current Measurement Test
2023-06-11 Added test data
    [resource_data.csv]
2023-06-14 Modified Battery Consumption Logger to include only current
2023-06-14 Modified Serial Data Logger to handle Keyboard Interrupts
2023-06-16 Updated loggers to write data in .csv and use different calibration range
2023-06-16 Added Battey Consumption Analysis Notebook and FDS sample data
    [fds_data.csv, timestamps.csv]
2023-06-17 Added AQMS current data and encapsulated functionality in helper functions in Battery Consumption Analysis Notebook
    [aqms_data.csv, timestamps.csv]
2023-06-17 AQMS Comms: Added additional flow control in obtaining IP address
2023-06-21 Updated AQMS current data to reflect new functionality
    [aqms_data.csv, timestamps.csv]
2023-06-21 FDS: Added new current data
    [fds_data.csv, timestamps.csv]
2023-06-22 Updated CPS data, consumption notebook
    [cps_data.csv, timestamps.csv]
2023-06-23 Moved Comms.h into Arduino Libraries folder
2023-06-24 Fixed the issue arising from AQMS giving invalid readings
    [AirQualityMonitoringSystem.cpp, AirQualityMonitoringSystem.h]
2023-06-26 New Resource Utility Data
    [resource_data.csv]
2023-06-26 Added Jupyter Notebook w/ timestamped data
    [timestamps.csv]
2023-06-26 Updated Battery Consumption Notebook
2023-06-29 Collected battery consumption data regarding change/no change in state for CPS
    [cis_timestamps.csv, cps_cis_data.csv, cps_ss_data.csv, ss_timestamps.csv]
2023-06-29 Updated Battery Consumption notebook to include new CPS data
2023-06-30 Added Publishing Plots Script
    [cps_cis_timestamps.csv, cps_ss_timestamps.csv]
2023-06-30 Added battery consumption plots for publication/presentation purposes
2023-06-30 Updated AQMS battery consumption data to contain 3 full cycles
    [aqms_data.csv, timestamps.csv]
2023-06-30 Updated Publishing Plots Script to include calculating average current load and battery lifetime, Notebook for new data and new functionality from plots script
2023-06-30 Updated battery consumption plots as a result of new data
2023-07-01 Changed battery consumption plot size to 7.5x3.75 inches
2023-07-01 Modified battery consumption plot sizes to be 5.78x3.57 inches
2023-07-04 Modified data and plots due to there being 600 data points rather than 1200 data points on load plot
    [timestamps.csv]
2023-07-04 Added maximum and minimum to battery consumption analysis notebook
